iamdamosuzuki/Kiwi106-TeensyMIDIControl/Kiwi106-TeensyMIDIControl.ino

#include <MIDI.h>
#include "Controller.h"

/*************************************************************
  Kiwi-106 MIDI Controller Using Teensy 3.2
  
  bassed on:  MIDI CONTROLLER  by Notes and Volts  www.notesandvolts.com

  Morgan Notes
  7/17/23
  I believe this is all working. LEDs will need to be tested
  SysEx for Arp Speed is working. Individual pots and switches have been tested. 
  Comments have been put in for clarity
  Time to build and test!

 *************************************************************/

MIDI_CREATE_DEFAULT_INSTANCE();

//************************************************************
//***SET THE NUMBER OF CONTROLS USED**************************
//************************************************************
//---How many buttons are connected directly to pins?---------
byte NUMBER_BUTTONS = 0;
//---How many toggles are connected directly to pins?--
byte NUMBER_TOGGLES = 4;
//---How many potentiometers are connected directly to pins?--
byte NUMBER_POTS = 16;
//-----Sets default MIDI channel, which can be switched using dented knob
byte midiChannel = 1;

//************************************************************

//***DEFINE DIRECTLY CONNECTED POTENTIOMETERS************************
//Pot (Pin Number, Command, CC Control, Channel Number)
//**Command parameter is for future use**

Pot PO1(A0, 0, 105, 1);       //  Detune  
Pot PO2(A1, 0, 11, 1);        //  PWM Source Select     // LED 0, 5, 6, 7, 8, 9
Pot PO3(A2, 0, 15, 1);        //  DCO ENV Source Select // LED 10, 12
Pot PO4(A3, 0, 14, 1);        //  DCO ENV Amount
Pot PO5(A4, 0, 48, 1);        //  VCF ENV Source Select // LED 24, 25
Pot PO6(A5, 0, 59, 1);        //  VCA LFO Amount
Pot PO7(A6, 0, 61, 1);        //  VCA ENV Mode          // LED 27, 28
Pot PO8(A7, 0, 72, 1);        //  Int Clock
Pot PO9(A8, 0, 0, 1);         //  Arp Subdivide and Seq Subdivide // Set CC to 0, which flips it to SysEx mode
Pot PO10(A9, 0, 22, 1);       //  LFO 2 Rate
Pot PO11(A10, 0, 23, 1);      //  LFO 2 Delay  // for some reason these CC values are backwards, so wrired up knob. in reverse
Pot PO12(A11, 0, 65, 1);      //  ENV 2 Attack
Pot PO13(A12, 0, 66, 1);      //  ENV 2 Decay
Pot PO14(A20, 0, 67, 1);      //  ENV 2 Sustain
Pot PO15(A14, 0, 68, 1);      //  ENV 2 Release 
Pot PO16(A15, 0, 127, 1);     //  MIDI CHANNEL SELECT (special CC 127, MUST USE 11 POINT DENTED POT)
//*******************************************************************
//Add pots used to array below like this->  Pot *POTS[] {&PO1, &PO2, &PO3, &PO4, &PO5, &PO6};
Pot *POTS[] {&PO1, &PO2, &PO3, &PO4, &PO5, &PO6, &PO7, &PO8, &PO9, &PO10, &PO11, &PO12, &PO13, &PO14, &PO15, &PO16};
//Pot *POTS[] {&PO1, &PO2, &PO3, &PO4, &PO5, &PO6, &PO7, &PO8, &PO9, &PO10, &PO11, &PO12, &PO13, &PO14, &PO15, &PO16};
//*******************************************************************

//***DEFINE DIRECTLY CONNECTED TOGGLES*******************************
//Toggle (Pin Number, Command, Channel, Debounce Time)

Toggle TG1(2, 106, 1, 5 );    //    Detune Mode
Toggle TG2(3, 13, 1, 5 );     //    DCO LFO Source
Toggle TG3(4, 46, 1, 5 );     //    VCF LFO Source
Toggle TG4(29, 60, 1, 5 );    //    VCA LFO Source

//*******************************************************************
//Add toggles used to array below like this->  Toggle *TGS[] {&TG1, &TG2, &TG3, &TG4, &TG5, &TG6, &TG7, &TG8};
//Toggle *TOGGLES[] {&TG1, &TG2, &TG3, &TG4};
Toggle *TOGGLES[] {&TG1, &TG2, &TG3, &TG4};
//*******************************************************************


//***DEFINE DIRECTLY CONNECTED BUTTONS*******************************
//Button (Pin Number, Command, Note Number, Channel, Debounce Time)
//** Command parameter 0=NOTE  1=CC  2=Toggle CC **

//Button BU1(9, 1, 60, 1, 5 );    
//Button BU2(3, 0, 61, 1, 5 );
//Button BU3(4, 0, 62, 1, 5 );
//Button BU4(5, 0, 63, 1, 5 );
//Button BU5(6, 0, 64, 1, 5 );
//Button BU6(7, 0, 65, 1, 5 );
//Button BU7(8, 1, 64, 1, 5 );
//Button BU8(9, 2, 64, 1, 5 );
//*******************************************************************
//Add buttons used to array below like this->  Button *BUTTONS[] {&BU1, &BU2, &BU3, &BU4, &BU5, &BU6, &BU7, &BU8};
Button *BUTTONS[] {NULL}; //No buttons, gotta declare this as NULL to keep the code happy
//Button *BUTTONS[] {&BU1};
//*******************************************************************

void setup() {
  MIDI.begin(MIDI_CHANNEL_OFF);
  pinMode(0, OUTPUT);
  pinMode(5, OUTPUT);
  pinMode(6, OUTPUT);
  pinMode(7, OUTPUT);
  pinMode(8, OUTPUT);
  pinMode(9, OUTPUT);
  pinMode(10, OUTPUT);
  pinMode(11, OUTPUT);
  pinMode(24, OUTPUT);
  pinMode(25, OUTPUT);
  pinMode(27, OUTPUT);
  pinMode(28, OUTPUT);
  pinMode(LED_BUILTIN, OUTPUT);
  digitalWrite(LED_BUILTIN, HIGH);
}

void loop() {
  if (NUMBER_BUTTONS != 0) updateButtons();
  if (NUMBER_POTS != 0) updatePots();
  if (NUMBER_TOGGLES != 0) updateToggles();
}


//*****************************************************************
void updateButtons() {

  // Cycle through Button array
  for (int i = 0; i < NUMBER_BUTTONS; i = i + 1) {
    byte message = BUTTONS[i]->getValue();

    //  Button is pressed
    if (message == 0) {
      switch (BUTTONS[i]->Bcommand) {
        case 0: //Note
          MIDI.sendNoteOn(BUTTONS[i]->Bvalue, 127, midiChannel);
          break;
        case 1: //CC
          MIDI.sendControlChange(BUTTONS[i]->Bvalue, 127, midiChannel);
          break;
        case 2: //Toggle
          if (BUTTONS[i]->Btoggle == 0) {
            MIDI.sendControlChange(BUTTONS[i]->Bvalue, 127, midiChannel);
            BUTTONS[i]->Btoggle = 1;
          }
          else if (BUTTONS[i]->Btoggle == 1) {
            MIDI.sendControlChange(BUTTONS[i]->Bvalue, 0, midiChannel);
            BUTTONS[i]->Btoggle = 0;
          }
          break;
      }
    }

    //  Button is not pressed
    if (message == 1) {
      switch (BUTTONS[i]->Bcommand) {
        case 0:
          MIDI.sendNoteOff(BUTTONS[i]->Bvalue, 0, midiChannel);
          break;
        case 1:
          MIDI.sendControlChange(BUTTONS[i]->Bvalue, 0, midiChannel);
          break;
      }
    }
  }
}

//*****************************************************************
void updateToggles() {

  // Cycle through Toggle array
  for (int i = 0; i < NUMBER_TOGGLES; i = i + 1) {
    byte message = TOGGLES[i]->getValue();

    //  Toggle is Flipped Up
    if (message == 0) {
    //digitalWrite(LED_BUILTIN, HIGH);
    MIDI.sendControlChange(TOGGLES[i]->Tcontrol, 0, midiChannel); //switched numbers cuz i goofed the switches physically
    }

    //  Toggles is flipped down
    if (message == 1) {
    //digitalWrite(LED_BUILTIN, LOW);
    MIDI.sendControlChange(TOGGLES[i]->Tcontrol, 127, midiChannel);  //switched numbers cuz i goofed the switches physically
    }
  }
}
//***********************************************************************

void updatePots() {
  for (int i = 0; i < NUMBER_POTS; i = i + 1) {
    byte potmessage = POTS[i]->getValue();
    if (potmessage != 255){             //if pot message changes 
      Serial.print(i);
      Serial.print("\n");
      Serial.print(potmessage);
      Serial.print("\n");
      if (POTS[i]->Pcontrol == 0){      // CC value 0 trips it to perform SysEx Arp Speed Command
        processSysEx(potmessage);       // This funtion figures out the SysEx message to send to the arp speed command. 
      }
      else if (POTS[i]->Pcontrol == 127){      // CC value 127 trips it to perform MIDI channel command
        processMIDIChannel(potmessage);       // This funtion figures out the MIDI channel using the knotched knob. It debounces poorly, need to solve eventually
      }
      else{
        MIDI.sendControlChange(POTS[i]->Pcontrol, potmessage, midiChannel);
        updateLEDs(i, potmessage);      //This function handles LED feedback      
      }
    }
  }
}

void processMIDIChannel(byte potmessage) {
  byte temp_midiChannel = 1;
  if (potmessage == 1){
    temp_midiChannel = 1;
  }
  if (potmessage >= 2 && potmessage <= 5){
    temp_midiChannel = 2;
  }
  if (potmessage >= 6 && potmessage <= 20){
    temp_midiChannel = 3;
  }
  if (potmessage >= 21 && potmessage <= 47){
    temp_midiChannel = 4;
  }
  if (potmessage >= 38 && potmessage <= 50){
    temp_midiChannel = 5;
  }
  if (potmessage >= 51 && potmessage <= 68){
    temp_midiChannel = 6;
  }
  if (potmessage >= 69 && potmessage <= 85){
    temp_midiChannel = 7;
  }
  if (potmessage >= 86 && potmessage <= 100){
    temp_midiChannel = 8;
  }
  if (potmessage >= 101 && potmessage <= 120){
    temp_midiChannel = 9;
  }
  if (potmessage >= 121 && potmessage <= 126){
    temp_midiChannel = 10;
  }
  if (potmessage == 127){
    temp_midiChannel = 11;
  }
  if (temp_midiChannel == midiChannel){
    return;
  }
  else{
    midiChannel = temp_midiChannel;
    return;
    //Serial.print(midiChannel);
    //Serial.print("\n");
    //return midiChannel;
  }
}

void processSysEx(byte potmessage) {
  byte arp_byte = 0;
  if (potmessage <= 14){
    arp_byte = 0x00;
  }
  if (potmessage >= 15 && potmessage <= 28){
    arp_byte = 0x01;
  }
  if (potmessage >= 29 && potmessage <= 42){
    arp_byte = 0x02;
  }
  if (potmessage >= 43 && potmessage <= 56){
    arp_byte = 0x05;
  }
  if (potmessage >= 57 && potmessage <= 70){
    arp_byte = 0x06;
  }
  if (potmessage >= 71 && potmessage <= 84){
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
    }
    if (potmessage >= 96 && potmessage <= 127){  //ENV 2 Inverted
      digitalWrite(27, HIGH);
      digitalWrite(28, HIGH);
    }
  }
  if (potNum == 6){ //Pot 7 VCA ENV Source / Mode
    if (potmessage <= 31){  //Gate
      digitalWrite(24, LOW);
      digitalWrite(25, LOW);
    }
    if (potmessage >= 32 && potmessage <= 63){  //ENV 1
      digitalWrite(24, HIGH);
      digitalWrite(25, LOW);
    }
    if (potmessage >= 64 && potmessage <= 127){  //ENV 2 
      digitalWrite(24, LOW);
      digitalWrite(25, HIGH);
    }
  }
}
